THETHYLAND/AutomatedModelFarm/README.md

# AutomatedModelFarm
This is a project completed as part of Computer Enginnering 3 project 3 class. 
The project was created and coded by Travis Hyland and Sean Grenham
The video can be found here -->https://youtu.be/Nk6Mo8CTsW0
